olevasseur/ping-pong-ball-thrower/print/launcher_base_bambu_p2s_0.4mm_tree_supports.3mf

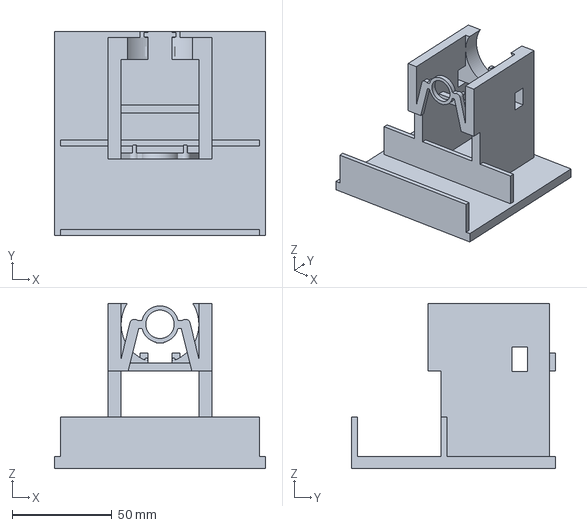
[picture p7: CAD file, 2026-10-13]
print/launcher_base_bambu_p2s_0.4mm_tree_supports.3mf
106.0 x 102.6 x 83.0 mm
