olevasseur/ping-pong-ball-thrower/stl/wheel_57mm.stl

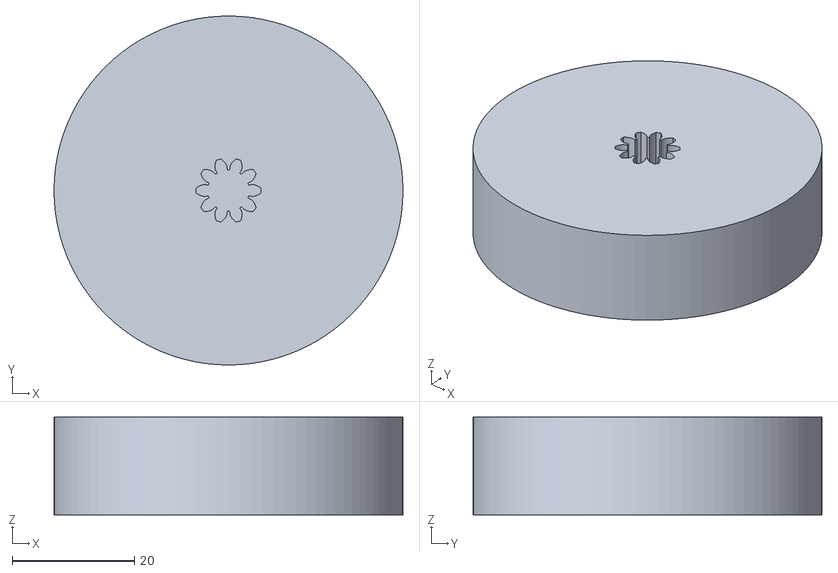
[picture p8: CAD file, 2026-10-13]
stl/wheel_57mm.stl
57.0 x 57.0 x 16.0
