olevasseur/ping-pong-ball-thrower/stl/rear_door.stl

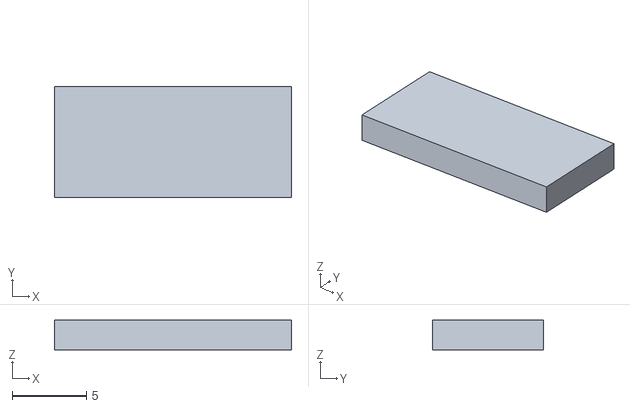
[picture p9: CAD file, 2026-10-13]
stl/rear_door.stl
16.0 x 7.50 x 2.00
