olevasseur/ping-pong-ball-thrower/(list of files, cad)

Other CAD files:
stl/launcher_base.stl
