olevasseur/ping-pong-ball-thrower/(commit log)

2026-10-13 Initial commit: ping-pong ball thrower
    [launcher_base.scad, launcher_base.stl, launcher_base_bambu_p2s_0.4mm_tree_supports.3mf, rear_door.stl, wheel_57mm.scad, wheel_57mm.stl]
2026-10-13 Add CAD renders of the motor mount from several angles
    [preview.scad]
